E-Cube0223/ElectronicCubePuzzle/README.md

# ElectronicCubePuzzle
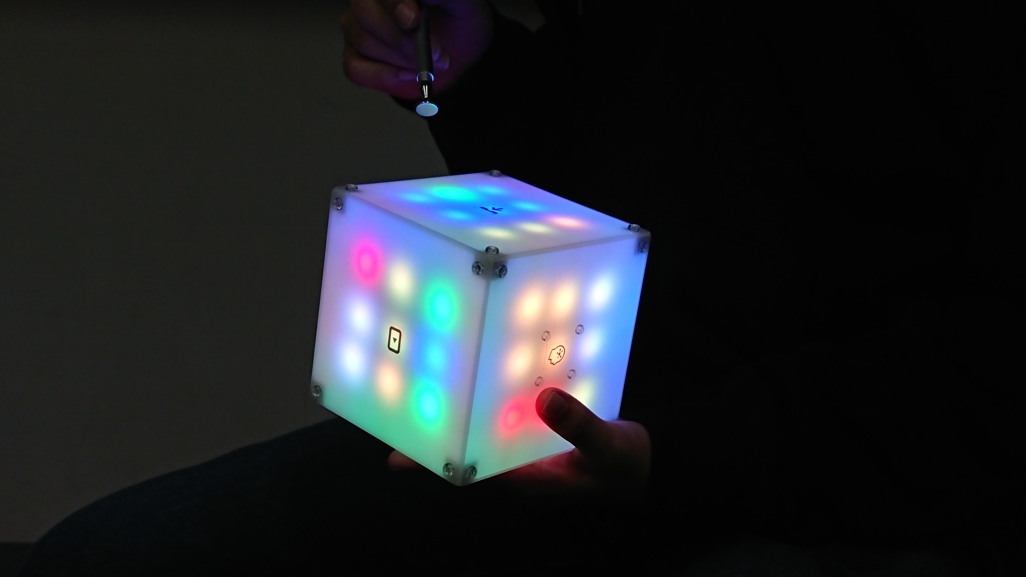
[picture p1: image/ECP.jpg]
ElectronicCubePuzzle

## ElectronicCubePuzzleとは
1マスの色をRGBフルカラーLEDで表現した，光るルービックキューブです。  
コンピュータがルービックキューブを解く自動解答機能や保存機能など，通常のルービックキューブにはできない機能を搭載しています。

LEDの光を主役としたきれいで楽しいデバイスを作りたいと考え，LEDキューブに着想を得て製作しました。

ルービックキューブとして，生活を彩るイルミネーションとして，あなたの生活に遊びと彩りをお届けします。
## 機能説明
### 通常操作
通常のルービックキューブと同じように端の列を回転させます。  
物理的に回転するのでは無く，本体の表面を専用のペンで図の細い矢印のようになぞることでLEDのパターンが変移します。  
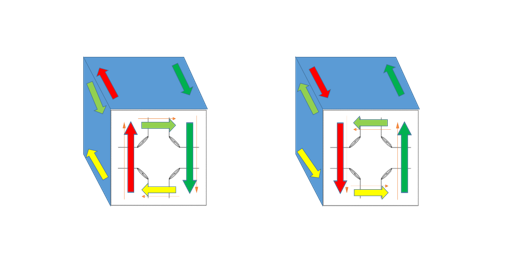
[picture p2: image/basic_operation.png]
basic_operation
  
### 中央列操作
中央の列を回転させます。  
こちらも通常操作と同じように，本体表面を専用のペンで図の細い矢印のようになぞることでLEDのパターンが変移します。  
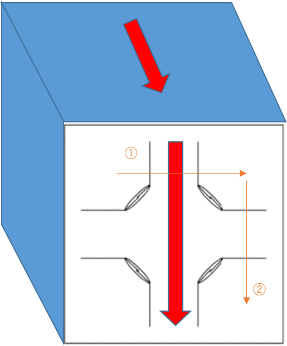
[picture p3: image/center_operarion.png]
center_operarion
  
### 特殊操作
ElectronicCubePuzzleは各面に1つ，計6個の特殊機能を搭載しています。  
どの面にどの機能が割り振られているかはアイコンで確認できます。   
指定の面の表面の角いずれかを専用のペンで専用のペンで図の細い矢印のように3回連続なぞることで各機能を呼び出すことができます。 

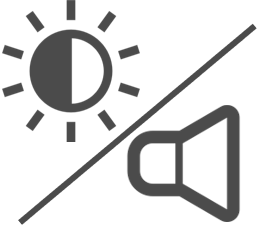
[picture p4: image/BrightnessVolume.png]
1. 輝度・音量調節     
LEDの明るさ・音のオンオフを組み合わせた5つのプリセットを機能呼び出しするたびに変更する。

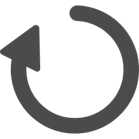
[picture p5: image/shuffle.png]
2. シャッフル         
ルービックキューブのマスをランダムで設置する。

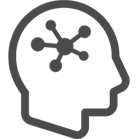
[picture p6: image/AutomaticAnswer.png]
3. 自動解答           
コンピュータが自動でパズルを解く機能。  
実際に解いている様子をLEDのアニメーションで表す。

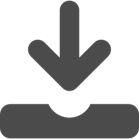
[picture p7: image/save.png]
4. セーブ             
ルービックキューブのマスの状態を保存する。

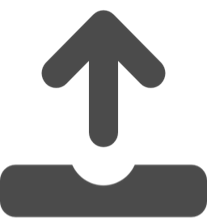
[picture p8: image/load.png]
5. ロード             
セーブした状態に戻す。

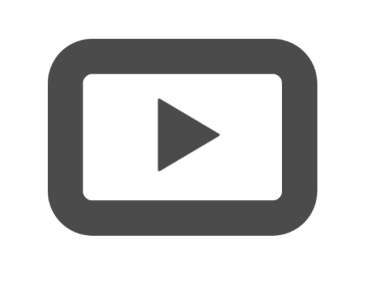
[picture p9: image/illumination.png]
6. イルミネーション   
シャッフルと自動解答を繰り返し実行する。  
イルミネーション中に機能再呼び出しで終了する。
ただ一定のパターンで光るイルミネーションでは無く，実際にルービックキューブを解いている様子が見れるロマン機能。

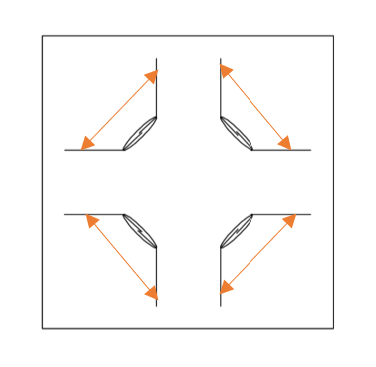
[picture p10: image/special_operation.png]
special_operation


## 開発環境
| 開発目的  | 開発ソフトフェア |
|:---:|:---:|
|プログラム	|	MPLAB X IDE(XC8)	|
|回路図		|	Eagle				|
|図面		|	Auto Cad			|

## 使用部品
| 部品名 | 数量|
|:---|:---:|
| PIC18f25k22									| 1 |
| PIC16f1827									| 6 |
|圧電ブザー										| 1 |
|リードスイッチＭＫＡ－１０１１０				|  24 |
|マイコン内蔵ＲＧＢ　ＰＬ９８２３－Ｆ５			|  54 |
|低損失レギュレータ　ＮＪＭ２３９６Ｆ０５		| 1 |
|ユニバーサル基盤(75mm×75mm)					| 6 |
|アクリル板(120mm×120mm)						| 2 |
|アクリル板(120mm×116mm)						| 2 |
|アクリル板(116mm×116mm)						| 2 |
|M4ねじキューブ									|  16 |
|M4ねじ											|  48 |
|M3スペーサー									| 多数|
|M3ねじ											| 多数|

## 回路図
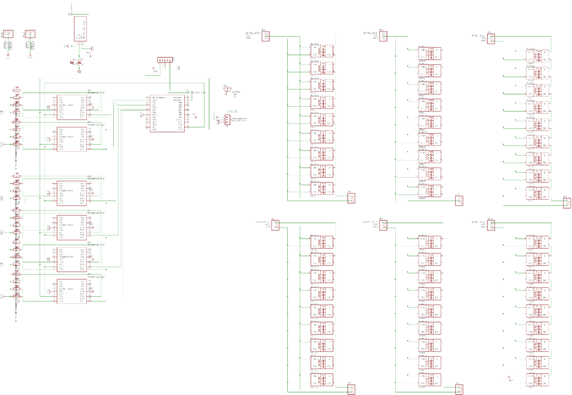
[picture p11: キューブ回路図/回路図.png]
回路図
  

## 写真・デモ動画公開
[一般公開(動作動画)](https://photos.app.goo.gl/gBsJXbdykWxxZE4S7)

[一般公開(雑多)](https://photos.app.goo.gl/xC9ibYifqtyYc6Wd8)
