E-Cube0223/ElectronicCubePuzzle/image/acrylic_cube.jpg

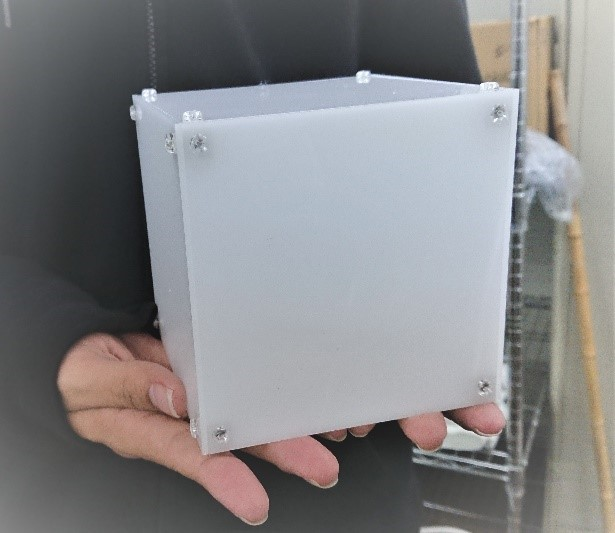
image/acrylic_cube.jpg
