E-Cube0223/ElectronicCubePuzzle/image/acrylic_drawing.png

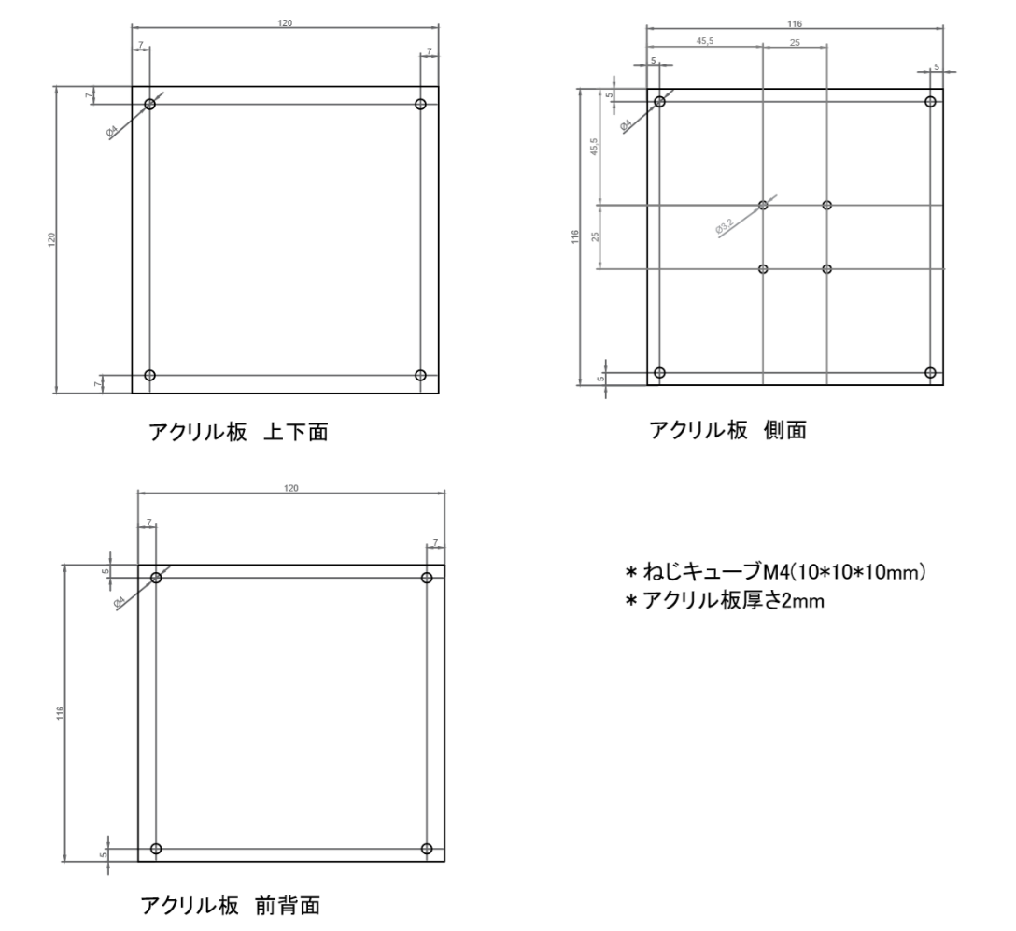
image/acrylic_drawing.png
