E-Cube0223/ElectronicCubePuzzle/image/IO_drawing2.png

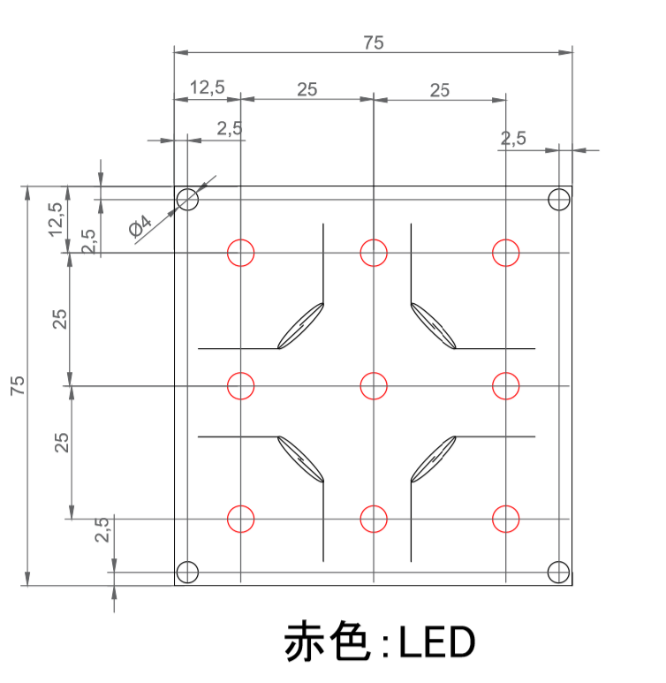
image/IO_drawing2.png
