E-Cube0223/ElectronicCubePuzzle/image/IO_drawing.png

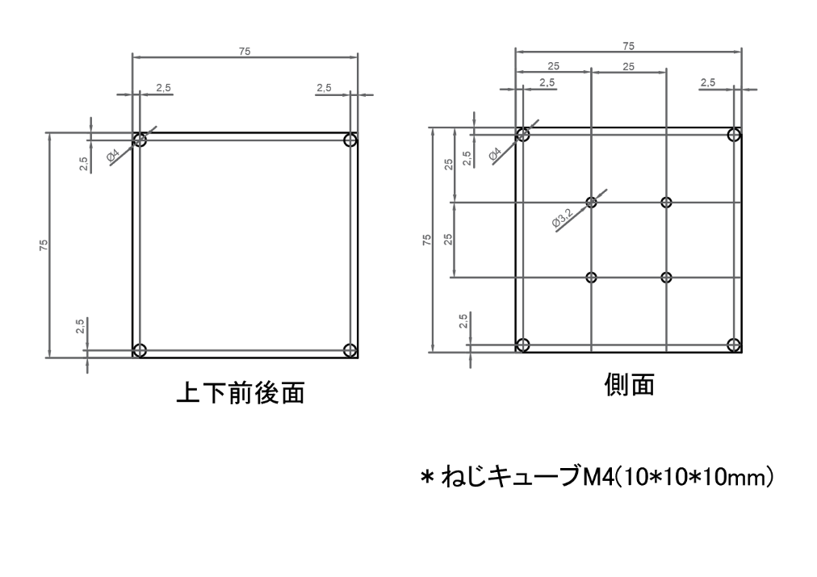
image/IO_drawing.png
