E-Cube0223/ElectronicCubePuzzle/image/pen.jpg

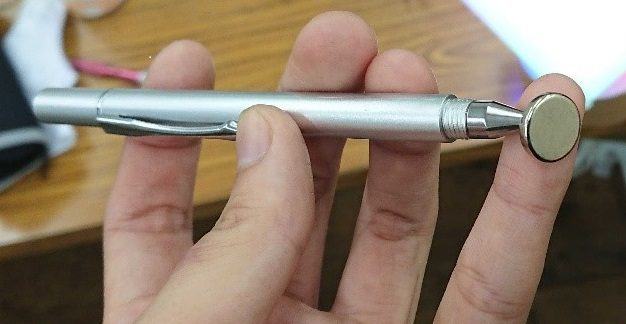
image/pen.jpg
