E-Cube0223/ElectronicCubePuzzle/image/ブロック図.png

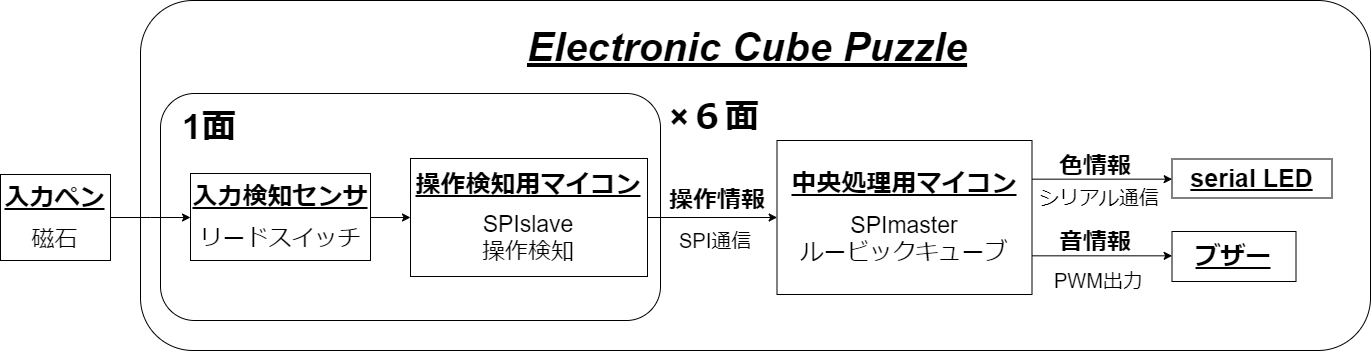
image/ブロック図.png
