E-Cube0223/ElectronicCubePuzzle/image/表紙.png

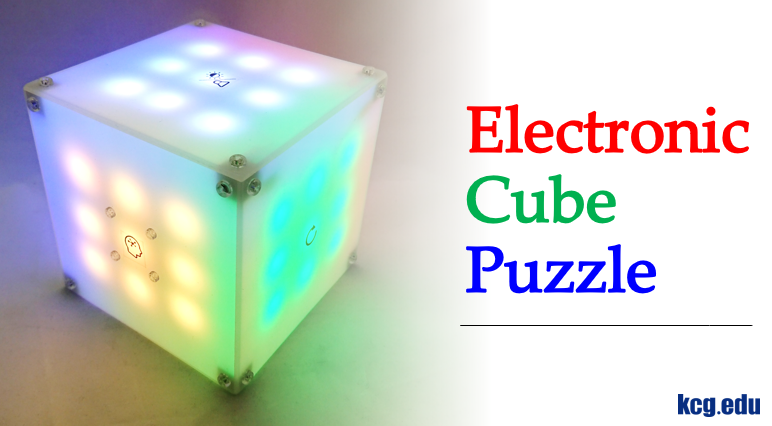
image/表紙.png
