E-Cube0223/ElectronicCubePuzzle/キューブ回路図/all_proen2.sch

## EAGLE design キューブ回路図/all_proen2.sch (2020-08-14)

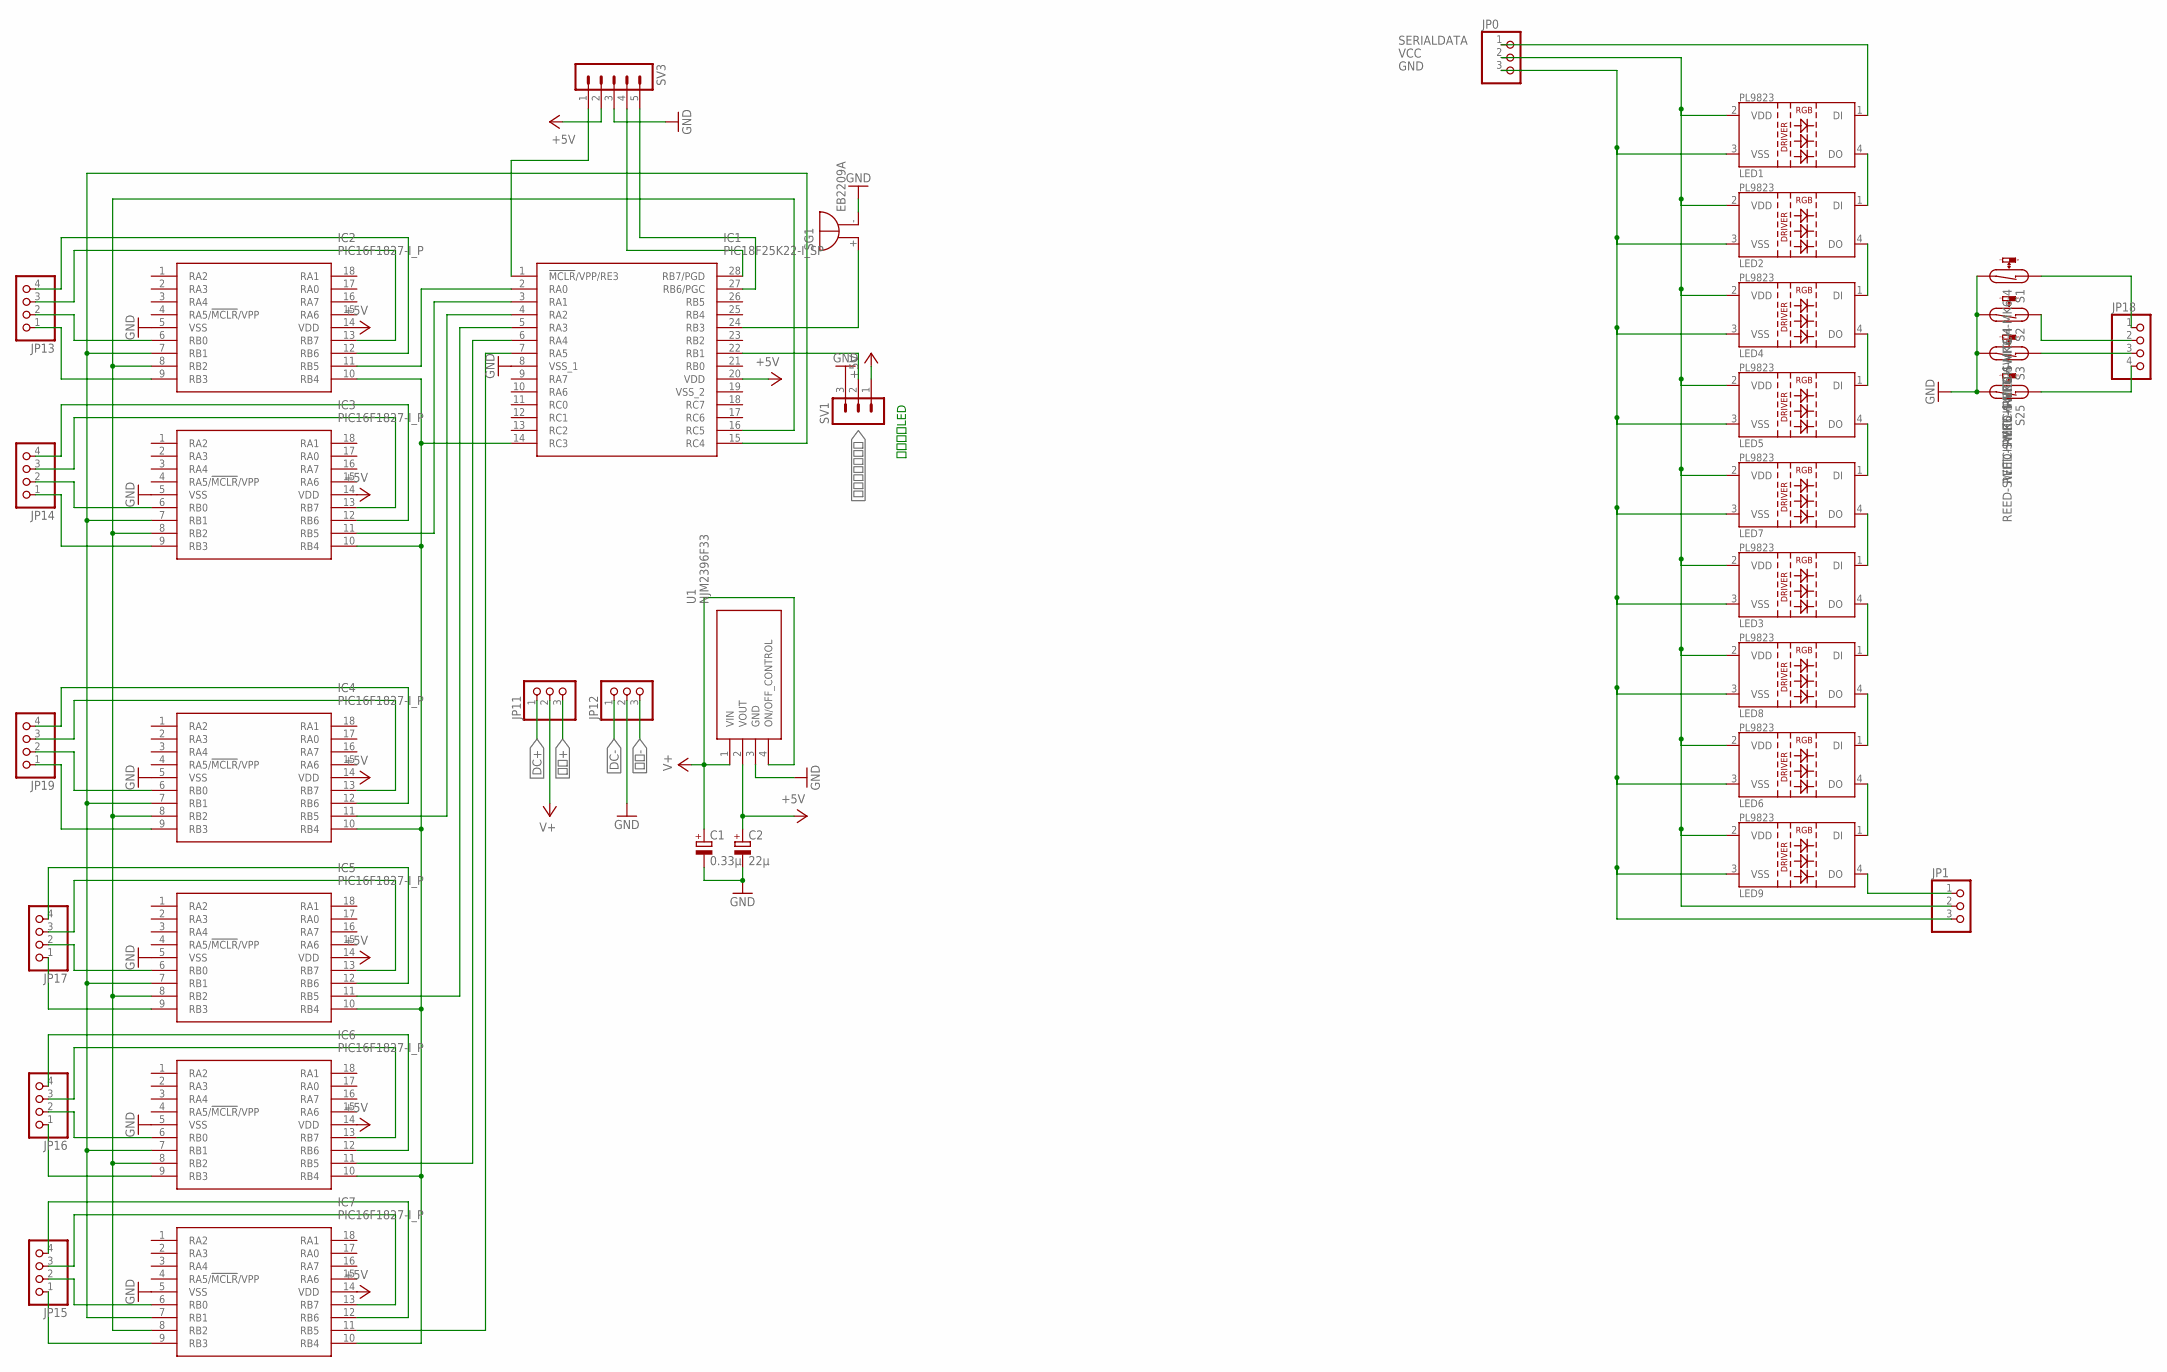
[picture p19: schematic all_proen2.sch]

Parts:
C1: 0.33μ; E2,5-6E
C2: 22μ; E2,5-6E
IC1: PIC18F25K22-I_SP; DIP794W56P254L3486H508Q28N
IC2, IC3, IC4, IC5, IC6, IC7: PIC16F1827-I_P; DIP794W56P254L2286H533Q18N
JP0, JP1, JP11, JP12: PINHD-1X3; 1X03
JP13, JP14, JP15, JP16, JP17, JP18, JP19: PINHD-1X4; 1X04
LED1, LED2, LED3, LED4, LED5, LED6, LED7, LED8, LED9: LED-PL9823-F5
S1, S2, S3, S25: REED-SWITCH-MK6-4; MK6-4
SG1: EB2209A
SV1: MA03-1
SV3: MA05-1
U1: NJM2396F33; TO254P480X1000X1900-4P

Connections:
+5V: C2.+, IC1.20 (VDD), IC2.14 (VDD), IC3.14 (VDD), IC4.14 (VDD), IC5.14 (VDD), IC6.14 (VDD), IC7.14 (VDD), SV1.1, SV3.2, U1.2 (VOUT)
DC+: JP11.1
DC-: JP12.1
GND: C1.-, C2.-, IC1.8 (VSS_1), IC2.5 (VSS), IC3.5 (VSS), IC4.5 (VSS), IC5.5 (VSS), IC6.5 (VSS), IC7.5 (VSS), JP0.3, JP1.3, JP12.2, LED1.3 (VSS), LED2.3 (VSS), LED3.3 (VSS), LED4.3 (VSS), LED5.3 (VSS), LED6.3 (VSS), LED7.3 (VSS), LED8.3 (VSS), LED9.3 (VSS), S1.2, S2.2, S3.2, S25.2, SG1.-, SV1.3, SV3.3, U1.3 (GND)
unnamed: IC2.12 (RB6), JP13.4
unnamed: IC2.13 (RB7), JP13.3
unnamed: IC2.6 (RB0), JP13.2
unnamed: IC2.9 (RB3), JP13.1
unnamed: IC1.15 (RC4), IC2.7 (RB1), IC3.7 (RB1), IC4.7 (RB1), IC5.7 (RB1), IC6.7 (RB1), IC7.7 (RB1)
unnamed: IC1.16 (RC5), IC2.8 (RB2), IC3.8 (RB2), IC4.8 (RB2), IC5.8 (RB2), IC6.8 (RB2), IC7.8 (RB2)
unnamed: IC1.2 (RA0), IC2.11 (RB5)
unnamed: IC1.3 (RA1), IC3.11 (RB5)
unnamed: IC3.12 (RB6), JP14.4
unnamed: IC3.13 (RB7), JP14.3
unnamed: IC3.6 (RB0), JP14.2
unnamed: IC3.9 (RB3), JP14.1
unnamed: IC1.4 (RA2), IC4.11 (RB5)
unnamed: IC1.5 (RA3), IC5.11 (RB5)
unnamed: IC1.6 (RA4), IC6.11 (RB5)
unnamed: IC1.14 (RC3), IC2.10 (RB4), IC3.10 (RB4), IC4.10 (RB4), IC5.10 (RB4), IC6.10 (RB4), IC7.10 (RB4)
unnamed: IC4.12 (RB6), JP19.4
unnamed: IC4.13 (RB7), JP19.3
unnamed: IC4.6 (RB0), JP19.2
unnamed: IC4.9 (RB3), JP19.1
unnamed: IC1.7 (RA5), IC7.11 (RB5)
unnamed: JP18.1, S1.1
unnamed: IC5.9 (RB3), JP17.1
unnamed: IC1.24 (RB3), SG1.+
unnamed: IC5.12 (RB6), JP17.4
unnamed: IC5.13 (RB7), JP17.3
unnamed: IC5.6 (RB0), JP17.2
unnamed: IC6.9 (RB3), JP16.1
unnamed: JP18.4, S25.1
unnamed: IC1.1 (!MCLR!/VPP/RE3), SV3.1
unnamed: IC1.28 (RB7/PGD), SV3.4
unnamed: IC1.27 (RB6/PGC), SV3.5
unnamed: IC6.12 (RB6), JP16.4
unnamed: IC6.13 (RB7), JP16.3
unnamed: IC6.6 (RB0), JP16.2
unnamed: IC7.9 (RB3), JP15.1
unnamed: LED1.4 (DO), LED2.1 (DI)
unnamed: LED2.4 (DO), LED4.1 (DI)
unnamed: LED4.4 (DO), LED5.1 (DI)
unnamed: LED5.4 (DO), LED7.1 (DI)
unnamed: IC7.12 (RB6), JP15.4
unnamed: IC7.13 (RB7), JP15.3
unnamed: IC7.6 (RB0), JP15.2
unnamed: LED3.1 (DI), LED7.4 (DO)
unnamed: LED3.4 (DO), LED8.1 (DI)
unnamed: LED6.1 (DI), LED8.4 (DO)
unnamed: LED6.4 (DO), LED9.1 (DI)
unnamed: JP1.1, LED9.4 (DO)
unnamed: JP18.3, S3.1
unnamed: JP18.2, S2.1
SERIALDATA: JP0.1, LED1.1 (DI)
V+: C1.+, JP11.2, U1.1 (VIN), U1.4 (ON/OFF_CONTROL)
VCC: JP0.2, JP1.2, LED1.2 (VDD), LED2.2 (VDD), LED3.2 (VDD), LED4.2 (VDD), LED5.2 (VDD), LED6.2 (VDD), LED7.2 (VDD), LED8.2 (VDD), LED9.2 (VDD)
シリアルデータ: IC1.22 (RB1), SV1.2
電池+: JP11.3
電池-: JP12.3

Notes on the sheet:
シリアルLED
