E-Cube0223/ElectronicCubePuzzle/source_code/master_main_ver5_9.X/EEROM_WR.h

#ifndef EEROM_WR_H
#define	EEROM_WR_H
#include "operation_CES.h"
#include <htc.h>

#include <xc.h> 

#define EEROM_DEF_FLAG_ADDRESS 0
#define EEROM_SAVE_FLAG_ADDRESS 1
#define EEROM_GAME_FLAG_ADDRESS 2
#define EEROM_DEF_START_ADDRESS 3
#define EEROM_SAVE_START_ADDRESS 49

#define GAME_FLAG_ON 1
#define GAME_FLAG_OFF 0

void EEROM_WR_ioport(void);
void EEROM_R_DEFF(void);
void EEROM_W_DEFF(void);

void DATAEE_WriteByte(unsigned char bAdd, unsigned char bData);

unsigned char DATAEE_ReadByte(unsigned char bAdd);
extern char game_flag;
extern CE save_CE;
void EEROM_R_SAVE(void);
void EEROM_W_SAVE(void);

void EEROM_GAME_ON(void);

void EEROM_GAME_OFF(void);

#endif	
