E-Cube0223/ElectronicCubePuzzle/source_code/master_main_ver5_9.X/make_log.c

#include<stdio.h>
#include"make_log.h"

FILE *fp;

void setup_log(const char file_name[]){
	fp = fopen(file_name, "w");
	if(fp==NULL){
		printf("ファイルが開けませんでした\n");
	}
}

void endup_log(void){
	fclose(fp);
	printf("ファイルを閉じました");
}

//fprintf(fp,"%s,%s",ts,te);
