E-Cube0223/ElectronicCubePuzzle/source_code/master_main_ver5_9.X/master/master_SPI.c

/*
 * File:   master_SPI.c
 * Author: NAOYUKI
 *
 * Created on 2019/10/21, 18:14
 */

#include "master_SPI.h"

/*
 * SPI通信での受信
 * SSPINの操作は関数内で行わない
 * 受信データを1bit分だけシフト操作を行う
 */
char SPIreadM(void) {
    char dumy;
    //CS0 = 0; //CS Low
    //SSP1CON1bits.WCOL = 0;
    //   dumy = SSP1BUF; //ダミーデータ
    SSP1BUF = 0; //データ送信
    while (!SSP1STATbits.BF)
        ; //データ受信完了
    //CS0 = 1; //CS High
    return ((SSP1BUF >> 1)); //データ取得
}

/*
 * SPI通信での受信
 * SSPINの操作は関数内で行う
 * 詳細はSPI_readM()
 */
char SPI_readM_2(const char csPIN) {
    int i = 0;
    char data;
    for (i = 0; i < 2; i++) { //スレーブ選択
        switch (csPIN) {
            case 0:
                CS0 = i;
                break;
            case 1:
                CS1 = i;
                break;
            case 2:
                CS2 = i;
                break;
            case 3:
                CS3 = i;
                break;
            case 4:
                CS4 = i;
                break;
            case 5:
                CS5 = i;
                break;
        }
        if (i == 0)
            data = SPIreadM(); //データ受信
    }
    return data;
}

void SPI_M_ioport(void) {
    //    SSP1BUF = 0;
    SSP1STATbits.SMP = 0;
    SSP1STATbits.CKE = 0;
    SSP1CON1bits.SSPEN = 1;
    SSP1CON1bits.CKP = 0;
    SSP1CON1bits.SSPM = 0b0000;

    SSP1CON1 = 0b00100001; // クロック極性はLOW　マスタモードでFOSC/16のクロックに設定
    SSP1STAT = 0b00000000; // クロック位相は０、アイドル(0V)→アクティブ(5V)時にデータ送信

    TRISCbits.TRISC4 = 1; //SDI入力
    TRISCbits.TRISC5 = 0; //SDO出力
    TRISCbits.TRISC3 = 0; //SCK出力

    //全CS用PIN出力
    TRISAbits.TRISA0 = 0;
    TRISAbits.TRISA1 = 0;
    TRISAbits.TRISA2 = 0;
    TRISAbits.TRISA3 = 0;
    TRISAbits.TRISA4 = 0;
    TRISAbits.TRISA5 = 0;

    ANSELCbits.ANSC3 = 0;
    ANSELCbits.ANSC4 = 0;
    ANSELCbits.ANSC5 = 0;

    //CSを未選択状態に
    CS0 = 1;
    CS1 = 1;
    CS2 = 1;
    CS3 = 1;
    CS4 = 1;
    CS5 = 1;
}

void SPI_RET(void) {
    for (char i = 0; i < 10; i++) {
        SPI_RET_2();
        __delay_ms(50);
    }
}

void SPI_RET_2(void) {
    for (char j = 0; j < 6; j++) {
        while (SPI_readM_2(j) != 0);
    }
}
