E-Cube0223/ElectronicCubePuzzle/(commit log)

2020-08-14 回路図アップロード
    [all_proen2.sch]
2020-08-14 表紙画像アップロード
2020-08-25 Update README.md (動画リンク追加)
2020-08-25 Update README.md
    特殊操作方法1部修正
